AlonRR/parts/models/usbc-panel-plate/parameter-map.png

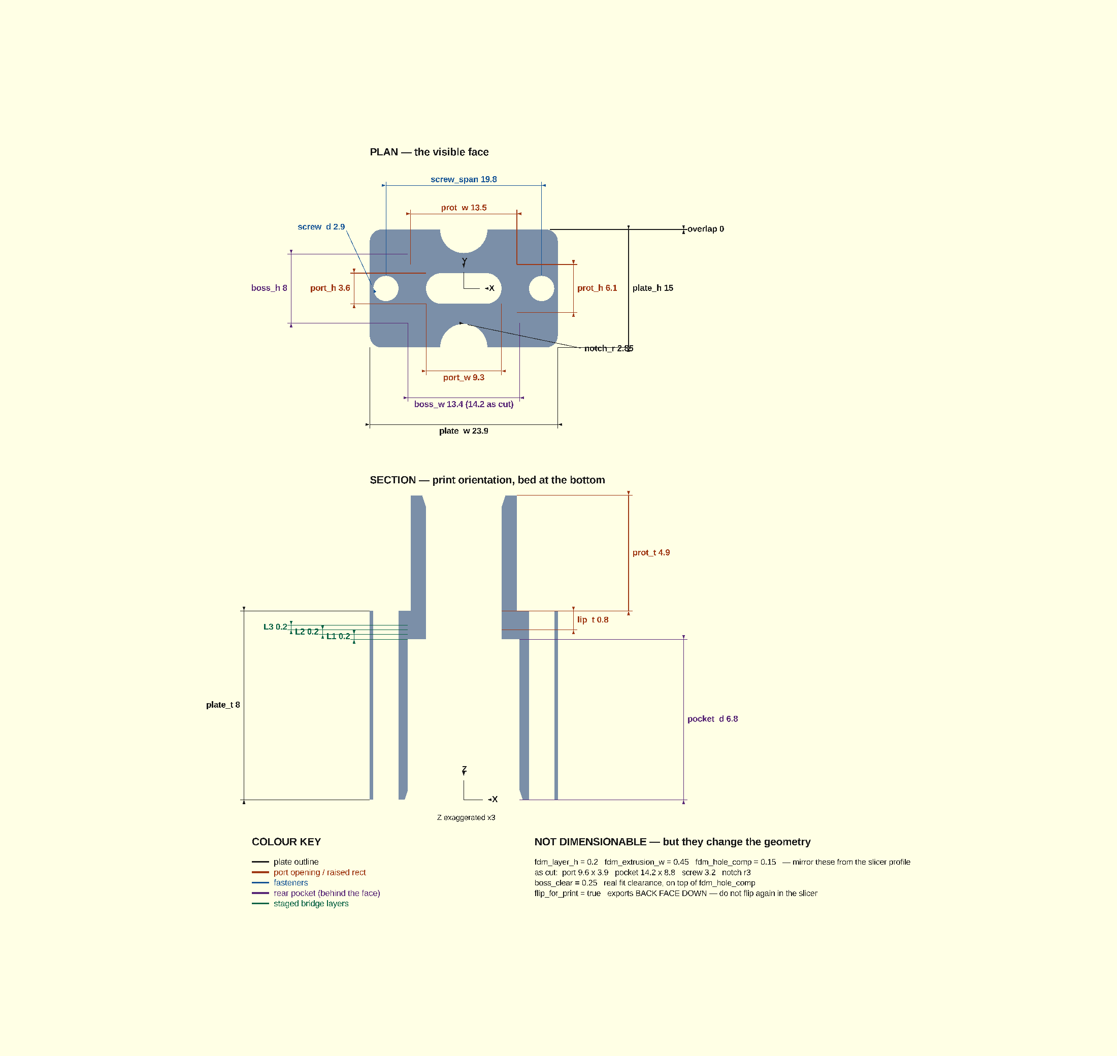
models/usbc-panel-plate/parameter-map.png
