AlonRR/parts/(list of files, cad)

Other CAD files:
models/usbc-panel-plate/usbc-panel-plate.scad
