AlonRR/parts/(commit log)

2026-08-17 feat(models): add parametric USB-C panel plate
    A rectangle with three holes -- USB-C opening in the middle, one screw hole
    either side -- that covers an oversized panel opening and gives the connector's
    own screws something to pull against.
    Fits the commodity IP67-style panel-mount USB-C feedthrough.
    Measured with calipers, across the connector's own flange holes:
    inner edge to inner edge = 16.90 mm
    outer edge to outer edge = 22.70 mm
    => centre-to-centre 19.80 mm, hole diameter 2.90 mm (M2.5, not M2)
    Case opening height measured at 15.00 mm; width still unmeasured, currently a
    21 mm placeholder.
    Plate outline is derived, not set: it must cover the opening AND keep both
    screw holes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
    [usbc-panel-plate.scad]
2026-08-17 feat(models): size USB-C plate to the measured 23.4 x 15 opening
    Opening width measured at 23.4 mm, past the 21 mm point where the screw
    envelope stops governing. Plate is now 28.4 x 20 x 2.5 mm; material outboard
    of each screw improves from 1.65 to 2.85 mm.
    The measurement also settles how the part is retained, which was not obvious
    before: at 23.4 mm the opening is WIDER than the 22.70 mm screw envelope, so
    both screws pass through open air rather than through sheet metal. The plate
    is therefore clamped to the connector, not bolted to the panel, and the panel
    is trapped between the plate's 2.5 mm lap and the connector flange. The lap is
    the only thing retaining it, so overlap must not be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
    [usbc-panel-plate.scad]
2026-08-17 feat(models): close the USB-C opening down to the port itself
    The centre hole cleared the connector's whole raised boss, leaving open air
    visible around the port. It is now two levels: a 0.8 mm front lip sized to the
    receptacle (9.5 x 3.7), opening out behind into a 13.4 x 8.4 x 1.7 mm pocket
    that the boss nests into. Outline, screws and lap are unchanged.
    Panel measured at 0.6 mm, so the pocket accommodates a boss standing up to
    2.3 mm proud of the connector flange -- 1.7 mm of pocket plus the 0.6 mm the
    panel absorbs. Recorded as the thing to suspect if the plate will not sit flat.
    The lip only has to clear the plug's metal tongue, 8.34 x 2.56 mm and fixed by
    the USB spec, which 9.5 x 3.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
    [usbc-panel-plate.scad]
2026-08-17 feat(models): add half-circle notches to the plate's Y edges
    Semicircular cutouts bitten out of the top and bottom edges, radius 2 mm,
    centred by default. notch_x offsets the pair; notch_mirror puts one each side
    instead. notch_r = 0 removes them.
    Also folds in the two measured heights: exposed port area 4.7 mm (was 3.7) and
    connector boss 8.0 mm (was a photo-scaled 8.4). Both widths remain unmeasured
    and stay flagged <<CONFIRM>>, so this is not sliceable yet -- port_w in
    particular was reported as roughly 2 mm too wide, which would land near 7.5,
    under the 8.34 mm USB-C plug tongue. Cutting it on that arithmetic alone could
    produce a plate no cable fits, so it waits for the measurement.
    T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
    [usbc-panel-plate.scad]
2026-08-17 tweak(models): notch radius 2.0 -> 2.5
    Clearances re-checked and still healthy: 2.0 mm to the rear pocket, 9.1 mm to
    the nearest screw hole. Break-through into the case aperture deepens from
    1.0 to 1.5 mm.
    [usbc-panel-plate.scad]
2026-08-17 feat(models): measured boss 14.7 x 6.1; shrink plate to the opening
    Boss taken from "the port rectangle is 6.1 x 14.7". Assigned to the rear pocket
    rather than the front lip by elimination: a 14.7 x 6.1 opening in the lip would
    reopen the very gap the two-level opening exists to close. 6.1 supersedes an
    earlier 8.0 for this feature; the two numbers were reported for different
    rectangles and 6.1 arrived as a matched pair with 14.7.
    Also captures overlap dropped to 0.2 and the min_w margin commented out, which
    together shrink the plate to 23.8 x 15.4 -- essentially the aperture size.
    Two consequences the echoes now surface, neither of them errors:
    outboard of screw : 0.55 mm
    web beside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
    [usbc-panel-plate.scad]
2026-08-17 feat(models): add the 14.7 x 6.1 raised rectangle
    The measured 14.7 x 6.1 is a protrusion, not a recess, and it is in ADDITION to
    the rear pocket rather than replacing it -- so boss_w/boss_h revert to 13.4 x
    8.0 and the new prot_* parameters carry the measurement.
    prot_face selects which side it stands on. Because the outermost face is no
    longer necessarily z = 0, the cuts are now driven by computed front_z / cut_lo /
    cut_len instead of hardcoded offsets; the port opening, lead-in chamfer, Y-edge
    notches and screw holes all follow it. Without that the notches would have left
    stubs standing on the protrusion and the chamfer would have been cut into thin
    air inside the part.
    Four asserts gua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
    [usbc-panel-plate.scad]
2026-08-17 docs(models): the protrusion flips the print orientation
    Front-face-down was correct for a flat plate and is wrong now. With the
    protrusion on the front it lands on the bed and the plate's rim then starts in
    mid-air 1.5 mm up, overhanging about 4.6 mm all round, which needs real support.
    Back-face-down instead: the rear pocket prints as a plain cavity off the bed,
    the 0.8 mm lip bridges 8 mm across it, and the protrusion stands up on top fully
    supported. The slicer takes the pocket's short span, so it is an 8 mm bridge and
    not 13.4. One bridge, no supports.
    Noted that with prot_t = 0 the old advice applies again.
2026-08-17 docs: FDM design rules calibrated to this printer, plus a plate audit
    Generic guides quote a 1.2 mm minimum wall and a 0.4 mm nozzle. Neither is the
    governing number here. The profiles in this repo slice at 0.45 mm extrusion
    width, read out of the sliced G-code rather than assumed, so walls quantise to
    0.90 / 1.35 / 1.80 and vertical features to 0.2 + n * 0.15.
    That reframes the usual advice: a 1.1 mm wall is WORSE than 0.90, because it is
    two perimeters plus a 0.2 mm gap the slicer has to fudge into a void. Thickness
    between multiples buys nothing and costs solidity.
    Also captures that the slicer bridges an opening's SHORT axis, which is why the
    plate's 13.4 x 8.0 pocket is an 8 mm bridge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
    [usbc-panel-plate.scad]
2026-08-17 feat(models): one-layer ledge on the pocket -> lip transition
    The pocket ceiling had to reach 2.2 mm inward from the pocket wall to the lip
    opening in a single layer. pocket_steps inserts intermediate ledges, each one
    layer tall and sized between the two, so the reach is split into equal jumps.
    At the default of 1 that is two jumps of 1.1 mm for 0.15 mm of pocket depth --
    the cheap version of the 0.2 mm staircase, not the full 53 degree taper, which
    would have eaten 1.65 of the 1.7 mm available.
    Written as a loop rather than a hardcoded single ledge, so raising pocket_steps
    walks toward the smooth taper without a rewrite. Each cut runs to the top and
    the wider ones above simply win, which i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
    [usbc-panel-plate.scad]
2026-08-17 fix(models): step the pocket transition on one axis, not both
    The ledge interpolated in X and Y at once, so it ran right around the opening.
    pocket_step_axis now narrows only the chosen axis and holds the other at full
    pocket size, so that pair of walls drops straight to the lip with no ledge on
    them at all.
    Defaults to "y" because Y is the governing reach: X is 2.05 mm, Y is 2.20 mm,
    so splitting Y takes the worse of the two down to 1.10 mm.
    The echoes report both axes separately now rather than only the maximum. The
    old single "ceiling reach" line hid the fact that one axis still makes the jump
    in one go, which is exactly the thing worth seeing when only one axis is
    stepped:
    ceiling r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
    [usbc-panel-plate.scad]
2026-08-17 simplify(models): plain straight ledge at the hole edge
    Two fixes and a cull.
    The ledge sat at the midpoint between hole and pocket, so it read as recessed
    rather than as a step off the opening. It now steps out from the hole edge by
    step_out per side.
    It used rrect(), so its corners were rounded. Now square() -- straight sides.
    And the machinery around it is gone: the pocket_steps loop, the interpolation,
    the min() clamping, three echo lines and two asserts, all replaced by one
    conditional cut. Nothing used the generality; it was cost without a caller.
    [usbc-panel-plate.scad]
2026-08-17 feat(models): second straight ledge on the Y axis
    step_out/step_axis become step_x/step_y -- two independent ledges, one layer
    tall each, stacked: X steps at the lip, Y one layer above, then the pocket.
    The first ledge deliberately holds Y at the lip size rather than opening it to
    the pocket. Opening it there would take Y straight to full and leave the second
    ledge with nothing to step, which is the failure mode this shape exists to
    avoid.
    Assert now checks the stacked ledge height against the pocket depth, since two
    ledges consume twice what one did.
    [usbc-panel-plate.scad]
2026-08-17 tweak(models): ledges to 0.2 mm steps, 0.2 mm layers
    Matches the 0.2 mm print profile, so each ledge is exactly one layer instead of
    two. The pair now costs 0.4 mm of the 1.7 mm pocket depth rather than 0.8.
    A 0.2 mm step is also the figure the extrusion width supports: at 0.45 mm wide
    it leaves 56 % of each bead on the layer below. The previous 0.1 mm was under a
    quarter of a bead and would have rounded into the perimeter rather than
    resolving as a step.
    Re-sliced: 6m48s, 0.77 g ASA, layer_height 0.2, spiral_vase 0, perimeters 2.
    [usbc-panel-plate.scad]
2026-08-17 fix(models): ledge 1 steps X and Y, ledge 2 steps X only
    Had the shape wrong. It was X first then Y; it should be both axes together on
    layer 1 -- which is what compensates for the opening's corner rounding -- and X
    alone on layer 2, with Y holding where layer 1 left it.
    Collapses step_x/step_y to a single step, since both ledges now use the same
    amount and only differ in which axes move.
    Echoes the resulting bridge span rather than just the step size, because the
    span is the thing the ledges exist to reduce and it was not visible anywhere:
    bridge span : 4 mm after the ledges (was 4.4 mm)
    [usbc-panel-plate.scad]
2026-08-17 docs(models): echo per-layer reach in print order, flipped
    Printed back-face-down the ceiling closes going UP, so the transitions run
    pocket -> L2 -> L1 -> lip, and the ledges sit at the LIP end -- after the large
    reach has already been made, not before it:
    pocket->L2 : X 1.65 Y 2.0 <-- the big one
    L2->L1 : X 0.2 Y 0
    L1->lip : X 0.2 Y 0.2
    The single "ceiling reach: X 2.05, Y 2.2" line hid this. It reports the total
    gap between lip and pocket, which says nothing about how that gap is divided
    across layers, and dividing it is the entire point of the ledges.
    No geometry change -- this is diagnostics only. Whether the placement is right
    is a judgement for the operator: two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
    [usbc-panel-plate.scad]
2026-08-17 feat(models): export in print orientation, back face on the bed
    flip_for_print rotates 180 about X at the call site, so the STL arrives already
    oriented and no longer needs flipping in the slicer. The part spans -prot_t ..
    plate_t before rotation, so it is lifted by plate_t to put its lowest point back
    on z = 0.
    Verified from the exported STL rather than the preview: min_z 0, size_z 4.0
    (2.5 plate + 1.5 protrusion), manifold yes.
    Set flip_for_print = false to work in design orientation, which is what every
    comment in the file describes -- the geometry is still authored front-at-z-0 and
    only the final call is rotated, so nothing internal has to be read upside down.
    [usbc-panel-plate.scad]
2026-08-17 feat(models): ledges are a Y-grown slot then a rectangle
    Layer 1 keeps the lip's rounded slot profile and grows it in Y only. Layer 2 is
    a plain rectangle, and the square corners are what take out the slot's rounding
    before the ceiling closes over it.
    Replaces the previous pair, which stepped X and Y as two squares and left the
    rounded ends untouched -- so the corners were still curving inward under the
    bridge, which is the thing the ledges were meant to remove.
    Verified from the exported STL with thin slices through each ledge rather than
    from the preview: z 1.35 is a square-cornered rectangle, z 1.55 is the rounded
    slot.
    Drops the per-layer reach echo added last commit. It described the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
    [usbc-panel-plate.scad]
2026-08-17 feat(models): layer 1 rectangle, layer 2 two Y lines
    Layer 1 is a plain rectangle. Layer 2 is two lines running in Y only, one at
    each end of it -- | | -- rather than a second full opening.
    line_w defaults to 0.45, one extrusion at this profile's width, and line_len to
    8.0 so the lines run past the rectangle in Y. Both are exposed because neither
    follows from any measurement; they are the shape itself.
    Verified from the exported STL with thin slices at each ledge height rather than
    from the preview: z 1.35 shows the two lines flanking the rectangle, z 1.55 the
    plain rectangle alone.
    [usbc-panel-plate.scad]
2026-08-18 fix(models): apply all 16 findings from the sequential review
    The headline is not any single geometry change: every echo and assert computed
    from NOMINAL dimensions while every cut was grown by hole_comp, so each clearance
    was reported 0.15-0.30 mm better than the part had. "outboard of screw" read
    0.55 mm and was really 0.40 -- under one 0.45 mm extrusion, on the feature most
    likely to break, and quoted repeatedly as evidence the part was merely marginal.
    As-cut names (pw/ph/bw/bh/sd/nr/cbd) are now defined once at file scope and used
    by geometry, echoes and guards alike, so the audited number and the built
    geometry cannot drift apart.
    Structural:
    - min_w guard restored to screw_envelope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
    [usbc-panel-plate.scad]
2026-08-18 docs(models): parameter map — a named-measurement reference that cannot drift
    A numbered callout drawing of the plate: real outlines, a plan and a section,
    and a legend giving each number's parameter NAME and LIVE VALUE. It exists so
    both sides of a conversation about this part use the same word for the same
    measurement.
    Prior art checked first: BOSL2 already ships modules for exactly this, on the
    stated grounds that "sometimes it's hard to describe what each parameter does
    without a visual aid". There is no formal standard, but a dimensioned callout
    drawing kept beside the model is the established practice, so this follows it
    rather than inventing a notation.
    The drawing is GENERATED, n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
    [parameter-map.scad, usbc-panel-plate.scad]
2026-08-18 feat(models): two-bridge trick replaces the ledges; axes on the parameter map
    The ledges were solving the wrong problem. Printed back-face-down the layer that
    closes over the pocket IS the lip, and the lip has the port hole in it -- so this
    was never a plain bridge to be relieved, it was the classic "bridge with a hole
    in it", where the printer draws the hole's outline in mid-air.
    The two-bridge trick (Hackaday: sacrificial bridge; nophead: hanging holes)
    splits it into two anchored stages. Stage 1 opens the port out into a full-height
    slot, leaving two strips spanning wall-to-wall, each anchored at BOTH ends.
    Stage 2 closes down to the real port, its bands landing on those strips. Nothing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
    [parameter-map.scad, usbc-panel-plate.scad]
2026-08-18 feat(models): cross the bridge slot both ways, anchoring on four corners
    Stage 1 now slots the port out to full height AND full width, so the opening at
    that layer is a cross. What survives is four small corner pieces, each bounded
    by the pocket's own rounded corner -- a little rounded triangle hanging off the
    pocket wall.
    Those corners are what stage 2 bridges between, and crossing both ways changes
    the spans it has to make. Previously two strips ran the full 8.8 mm and every
    arm landed on them. Now the top and bottom arms span pw corner-to-corner and the
    left and right arms span ph:
    before stage 1 8.8 mm strips, stage 2 9.6 mm
    after stage 2 X 9.6 mm, Y 3.9 mm
    The Y ar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
    [usbc-panel-plate.scad]
2026-08-18 feat(models): three staged layers, each doing exactly one thing
    Drops the cross. The staging is now one job per layer, which is what makes it
    legible as well as printable -- no layer ever has to lay a straight run and a
    curve in the same pass:
    L1 the two bridge slot 9.6 x 8.8 two strips spanning 8.8 mm, anchored
    at both ends
    L2 the rectangle 9.6 x 3.9 square the other two sides bridge 9.6 mm onto
    those strips
    L3 the corners r2 fillets only laid on the solid rectangle below
    The third layer is the part the earlier attempts kept getting wrong. Closing
    straight from a rectangle to the rounded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
    [usbc-panel-plate.scad]
2026-08-18 refactor(models): group the slicer facts as fdm_*, derive the wall thresholds
    Yes to fdm_layer_h, but the rename was the smaller half. layer_h and hole_comp
    are facts about how the part gets MADE, not decisions about what it should BE --
    each has a counterpart in the print profile and the model is wrong the moment
    they disagree. Grouping and prefixing them says so at a glance instead of leaving
    it to be discovered by a bad print. layer_h was also filed under the bridge
    block, as if it belonged to that feature, when the plate_t alignment asserts
    depend on it too.
    The larger find was fdm_extrusion_w, which was not a parameter at all. It was
    sitting in the asserts as the literals 1.35 and 1.0,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
    [parameter-map.scad, usbc-panel-plate.scad]
2026-08-18 feat(models): dimension lines and colour groups on the parameter map
    Numbered dots answered the wrong question. A dot says "this feature"; the thing
    actually needed is "this distance, between these two edges". Every measurement is
    now a real dimension line -- extension lines back to the feature, arrowheads at
    both ends, name and live value on the line -- so what is being measured is never
    inferred. Leader lines remain only for the two things that are features rather
    than spans, screw_d and notch_r.
    Colour groups the families: outline, port/raised rect, fasteners, rear pocket,
    staged bridge layers. The pocket is behind the visible face, which a drawing
    would normally show dashed; colour carr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
    [parameter-map.scad]
2026-08-18 docs(models): correct the render command in the map header
    The sed that was meant to update it failed on an unescaped backslash, so the
    committed header still gave the old imgsize and camera -- which would have
    produced a cropped drawing for anyone who copied it.
    [parameter-map.scad]
2026-08-18 fix: harden scad-check against stale STLs; epsilon on the perimeter assert
    Two fixes, both found by running the new checker against a live edit rather
    than against the file it was written for.
    scad-check now deletes the STL before rendering. OpenSCAD leaves the previous
    STL untouched when a render fails, so every step after that was validating
    stale geometry -- and could report PASS on a model that does not build. That is
    the worst failure a verification tool can have, and it was in the tool written
    to catch exactly this class of thing.
    The edge-distance assert gets a 1e-9 epsilon. 3 * 0.45 evaluates to
    1.3500000000000001, so a design landing EXACTLY on three perimeters failed a
    bare >= co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
    [usbc-panel-plate.scad]
2026-08-18 feat(models): split guards into impossible (block) and compromised (warn)
    Asserting everything was too blunt. It meant exploring a design got blocked by
    problems that were judgement calls rather than impossibilities -- lowering
    overlap to see how small the plate could go stopped the render outright, when
    what was wanted was the part plus a clear statement of what it costs.
    BLOCK the geometry is impossible or self-contradictory: a feature vanishes,
    inverts, or cuts the part in two; an enum is misspelled. There is no
    sensible STL to produce.
    WARN it builds and prints, but something is compromised: a wall under the
    perimeter floor, a notch opening into the ca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
    [usbc-panel-plate.scad]
2026-08-18 feat(models): make the plate_w floor tunable, add edge-open screw slots
    plate_w was already at its floor, and the floor was invisible. It is the higher
    of two, and which one binds was not reported anywhere:
    COVERAGE gap_w + 2*overlap. Physics. No way around it.
    FASTENERS screw envelope + material outboard of each hole. A CHOICE, and the
    one that was actually binding: at overlap 0.5 coverage wants 24.4
    while the fasteners want 25.7.
    So "make it narrower" meant touching the fasteners, and nothing in the file said
    so. The echo now names which floor is binding and what the other would allow.
    screw_edge_margin exposes the 1.5 that was hardcoded inside min_w.
    s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
    [usbc-panel-plate.scad]
2026-08-18 refactor(models): split the plate into params header and geometry body
    Like C. usbc-panel-plate.params.scad holds every value you SET and nothing else
    -- no geometry, no modules, no derived values, so any line can be changed
    without reading the rest. usbc-panel-plate.scad includes it and holds the
    derived values, the modules, the geometry, the echoes and the guards. That file
    is still the one to render.
    min_w / cover_w / plate_w / plate_h move out of the parameter block, where they
    sat in the middle of the inputs under a heading that already said "derived,
    don't set these directly" -- true, and easy to miss when it is surrounded by
    things you are meant to set.
    Also removes usbc-panel-plate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
    [usbc-panel-plate.params.scad, usbc-panel-plate.scad]
2026-08-18 style(models): block comments, one long line per paragraph
    Both files reformatted to /* */ blocks with prose written as a single line per
    paragraph. Hard-wrapped line comments go ragged at every window width when the
    editor soft-wraps, which is how these are read.
    Hard breaks are kept only where they carry meaning -- the three-layer bridge
    diagram, the caliper derivation, the aligned as-cut column.
    Two things worth recording.
    Block comments do not nest. The first attempt embedded a literal close-comment
    token while explaining the section-marker syntax, which ended the comment there
    and left the rest of the paragraph to be parsed as code. That trap is now
    documented inside the file it brok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
    [usbc-panel-plate.params.scad, usbc-panel-plate.scad]
2026-08-18 style: block comments and unwrapped prose in the map and both scripts
    parameter-map.scad moves to /* */ with one long line per paragraph, matching
    the model files.
    The shell scripts keep # markers because sh has no block comment form -- the
    standing rule covers that case -- but the prose is unwrapped the same way, so it
    reflows with the window instead of going ragged.
    Hard breaks are preserved where they carry meaning: the render command in the
    map header, the BLOCK/WARN table in scad-check, the ASCII diagrams.
    Two things the reflow surfaced. Section dividers were absorbing the paragraph
    that followed them, since a divider is a comment line like any other to a naive
    joiner. And scad-check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
    [parameter-map.scad, usbc-panel-plate.params.scad]
2026-08-18 docs: state constraints in present tense, drop the changelog from the comments
    Six comments and four README passages narrated what an earlier version did and
    how it broke. Git holds that; a comment should say what the constraint IS.
    Each is rewritten forward: "1.35 used to appear as a literal" becomes "spelled as
    the literal 1.35 these would be magic numbers whose meaning lives where nothing
    can check it"; "an earlier version asserted both, which blocked exploration"
    becomes "asserting both would block exploration". Same warning, but it now reads
    as a rule rather than an anecdote, and it stays true regardless of what the file
    did last week.
    Kept in docs/fdm-design-rules.md, where the worke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
    [parameter-map.scad, usbc-panel-plate.params.scad, usbc-panel-plate.scad]
2026-08-18 fix(usbc-plate): split the coverage guard, which was false at corner_r=0
    The single test `overlap <= corner_min` conflated two different failures and
    degenerated at corner_r = 0: corner_min is then 0, the condition reads 0 <= 0,
    and it reported "the ROUNDED CORNERS fall inside the aperture" on a plate that
    has no rounded corners.
    Now two guards, one per failure:
    overlap <= 0 nothing in front of the panel is
    wider than the hole (any corner_r)
    corner_r > 0 && 0 < overlap <= corner_min straight edges cover, corners do not
    Both stay WARN. Zero lap is a deliberate choice here - the fitting is
    space-limited - so it is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
    [usbc-panel-plate.params.scad, usbc-panel-plate.scad]
2026-08-19 docs(usbc-plate): draw the flange measurement, record the notches as clearance
    flange-check.scad -> flange-check.png states the one open question in a form
    that can be answered with calipers: measure the connector flange's width A and
    height B, compare against the 23.4 x 15 aperture.
    Solid lines are values the model already knows; dashed and orange are the
    unknown. The section is cut through the HEIGHT deliberately - plate_h is
    gap_h + 2*overlap, so at overlap 0 it is exactly 15 and the plate edge lands
    precisely on the aperture edge. Cutting through the width would have been
    misleading: plate_w is pushed to 23.9 by the fastener floor, so it carries
    0.25 mm of lap the design does not rely o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
    [draw2d.scad, flange-check.scad, parameter-map.scad, usbc-panel-plate.params.scad]
2026-08-21 docs(fdm): how to join two printed parts - weld ASA, do not glue it
    The homelab purchasing session asked whether instant glue was the right buy
    for "bonding 3D-printed parts". It was not written down anywhere, so it had to
    be asked. Recording it here so the next session reads it instead.
    ASA and ABS solvent-weld in acetone, which fuses the parts into one piece and
    beats any adhesive. CA bonds only to the outer skin and fails by peeling the
    perimeter off the layer beneath. Acetone does not touch PLA and does not weld
    TPU, both on the shelf, so CA keeps real uses - just not as the primary plan.
    Also records that cyanoacrylate should not be mail-ordered: short shelf life,
    polymerises with age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
    [parameter-map.scad, usbc-panel-plate.params.scad]
2026-09-26 feat(licence): MPL-2.0 for code, CC-BY-4.0 for the rest, REUSE layout
    The repository was CC-BY-4.0 throughout. It holds two different kinds of
    work, and one licence was wrong for one of them: Creative Commons advises
    against a CC licence for software, because it carries no patent grant and
    says nothing about source availability. A firmware or script consumer needs
    both.
    So, from here on:
    firmware/ and scripts/ MPL-2.0
    everything else CC-BY-4.0
    Documentation, measured profile data and small printable parts are know-how
    rather than software, and CC-BY fits them and matches the norm for shared
    models.
    Laid out per the REUSE specification, matching the drybox repository so the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
    [draw2d.scad, flange-check.scad, parameter-map.scad, usbc-panel-plate.params.scad, usbc-panel-plate.scad]
2026-10-11 chore(scad-tools): the shared tools as a submodule, not copies
    A218 (Alon, 11 Oct 2026): scripts/scad-check.sh had fallen behind
    scad-tools' (no PARTS=N, slicer-repair warning or mesh edge check), and
    models/lib/axes.scad had drifted. scad-tools is pinned at 033e721; the
    copies go and every reference names scad-tools'. The README says how to
    fetch the submodule after a clone or a ZIP. Results on the four models
    and the plate's controls are the same as with the copies.
2026-10-11 refactor(models): gridfinity and draw2d from scad-tools' lib
    A220/A224 (Alon, 11 Oct 2026): scad-tools pinned at 10bcf6e, on GitHub.
    The gridfinity negative uses lib/gridfinity.scad - four negatives keep
    their facets, corners and volume, the echo unchanged (OpenSCAD 2021.01).
    The plate's two diagrams use lib/draw2d.scad and set $txt, $lw and $ah;
    draw2d.scad goes. Both diagrams render byte for byte as before.
    [draw2d.scad, flange-check.scad, parameter-map.scad]
2026-10-12 chore(repo): parts, starting with the USB-C plate from the toolkit
    The repository for finished printed parts agreed on 5 Oct 2026 (Q60,
    Q65, Q66) and started under D233 (a), 12 Oct. Its first part is the
    USB-C panel plate, split from the 3d-printing toolkit with its history:
    the 40 commits that touched models/usbc-panel-plate/, under the same
    path, all by the no-reply identity, and nothing private in any blob or
    message.
    Added: scad-tools as a submodule at 8e144c7 (on GitHub), so the
    diagrams' `use <../../scad-tools/lib/draw2d.scad>` resolves as it did in
    the toolkit; scad-project.toml for printables.py; REUSE licences as the
    toolkit had them (the plate CC-BY-4.0); .repo-status `ready`, awa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
2026-10-12 docs(usbc-plate): name the design rules and scad-check by their homes
    Out of the toolkit, `../../docs/fdm-design-rules.md` and
    `scripts/scad-check.sh` no longer exist beside the plate. The README
    links the design rules on the toolkit's GitHub, and the params comments
    say whose docs/fdm-design-rules.md and that scad-check is scad-tools'.
    Comments only: the echo and the solid are unchanged.
    [usbc-panel-plate.params.scad]
2026-10-12 docs(usbc-plate): README and diagrams at the 21 Aug values
    On 21 Aug 2026 the plate's params changed - plate_t 2.4 -> 8, prot_w
    14.4 -> 13.5, prot_t 1.5 -> 4.9, notch_r 1.8 -> 2.85 - inside a commit
    about welding ASA, with the parameter map's sec_y moved to fit, but
    nothing was regenerated. D237 (a), 12 Oct: keep those values and bring
    the documents to them.
    README: the "Current geometry" block is the model's echo again, now with
    the fourth warning (the notch comes within 0.1 mm of the rear pocket);
    the sketch, the provenance table (prot_w, prot_t, plate_t), the notch's
    reach (3 mm), the layer staging (print z 6.8 / 7.0 / 7.2 / 8.0, from the
    model) and the rim's overhang (5.2 mm in X, 4.45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
    [flange-check.scad, parameter-map.scad, usbc-panel-plate.params.scad]
